rtmcg/PID-Temperature-Controller/README.md

# PHYS-339
Code and hardware schematics for the the new PID temperature controller lab in the Physics 339 laboratory course at McGill university.
