rtmcg/PID-Temperature-Controller/Images/GUI.PNG

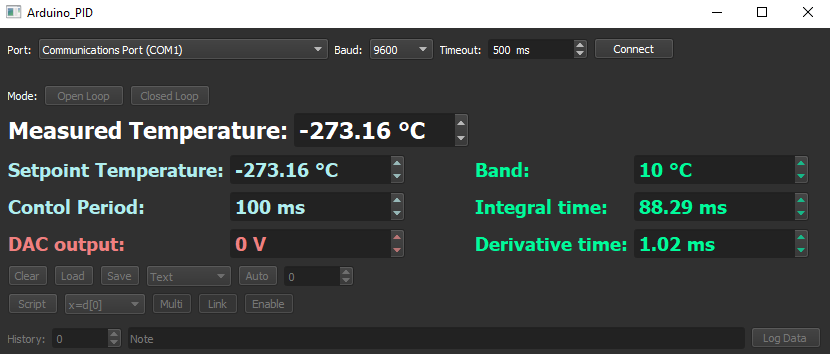
Images/GUI.PNG
