rtmcg/PID-Temperature-Controller/Images/GUI_plotting.PNG

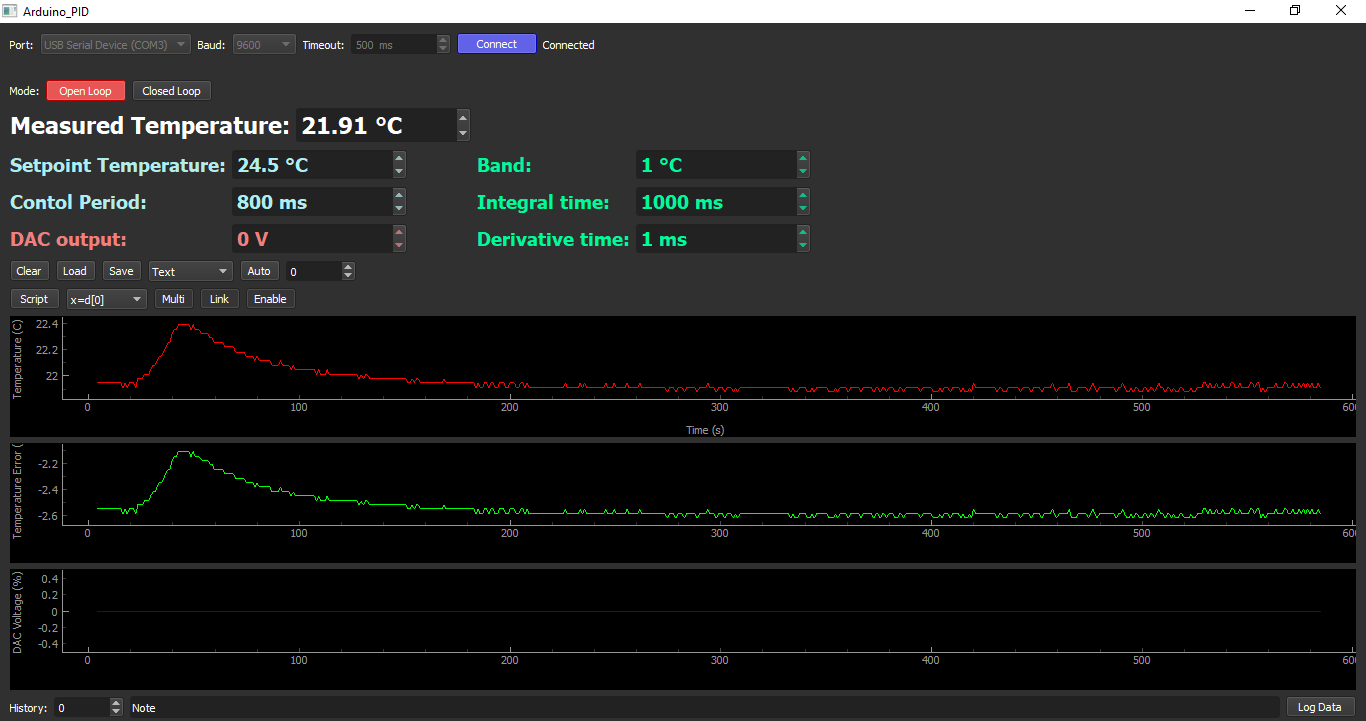
Images/GUI_plotting.PNG
