rtmcg/PID-Temperature-Controller/Electronics/PID_components_Digikey.xlsx

Index | Quantity | Part Number | Manufacturer Part Number | Description | Customer Reference | Available | Backorder | Unit Price | Extended Price USD
1 | 3 | 277-1580-ND | 1935190 | TERM BLK 5POS SIDE ENTRY 5MM PCB |  | 3 | 0 | 1.08 | 3.24
2 | 3 | 277-1578-ND | 1935174 | TERM BLK 3POS SIDE ENTRY 5MM PCB |  | 3 | 0 | 0.65 | 1.95
3 | 1 | PPC10.0KYCT-ND | SFR2500001002FR500 | RES 10K OHM 0.4W 1% AXIAL |  | 1 | 0 | 0.13 | 0.13
4 | 1 | 1109PHCT-ND | A104K15X7RF5TAA | CAP CER 0.1UF 50V X7R AXIAL |  | 1 | 0 | 0.26 | 0.26
5 | 1 | 1001PHCT-ND | A101J15C0GF5TAA | CAP CER 100PF 50V C0G/NP0 AXIAL |  | 1 | 0 | 0.29 | 0.29
6 | 1 | 2N7000BU-ND | 2N7000BU | MOSFET N-CH 60V 200MA TO92-3 |  | 1 | 0 | 0.42 | 0.42
7 | 1 | PPC20.0KYCT-ND | SFR2500002002FR500 | RES 20K OHM 0.4W 1% AXIAL |  | 1 | 0 | 0.13 | 0.13
8 | 1 | 470QBK-ND | CFR-25JB-52-470R | RES 470 OHM 5% 1/4W AXIAL |  | 1 | 0 | 0.1 | 0.10
9 | 1 | 296-7141-5-ND | LF412CP | IC OPAMP JFET 2 CIRCUIT 8DIP |  | 1 | 0 | 1.7 | 1.70
10 | 1 | 100KQBK-ND | CFR-25JB-52-100K | RES 100K OHM 5% 1/4W AXIAL |  | 1 | 0 | 0.1 | 0.10
