rtmcg/PID-Temperature-Controller/Electronics/Peltier Driver/PID_electronics.pdf

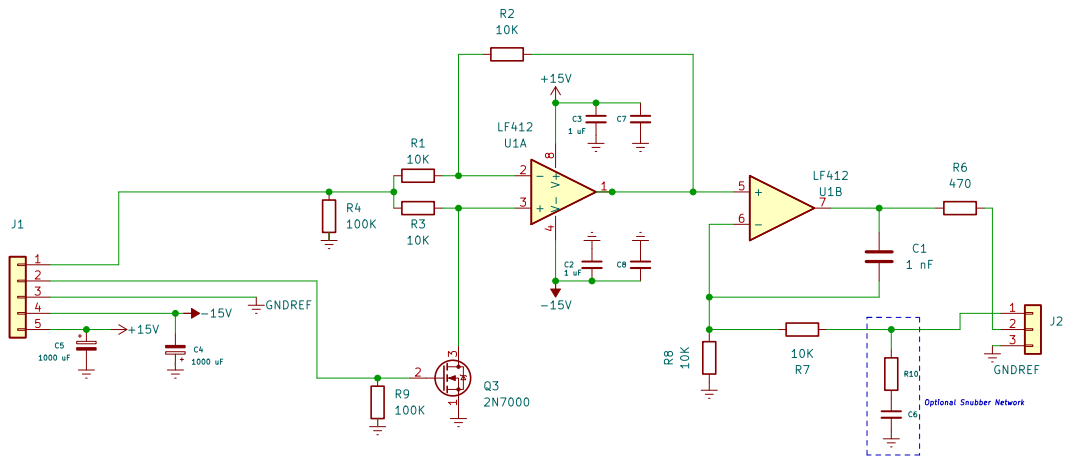
[picture p3: page 1]

File: PID_electronics.kicad_sch Sheet: / McGill University

Id: 1/1 Title: Peltier PID controller lab electronics
