rtmcg/PID-Temperature-Controller/Electronics/Peltier Driver/PID_electronics.kicad_pcb

## KiCad design Electronics/Peltier Driver/PID_electronics.kicad_pcb (2022-02-03)

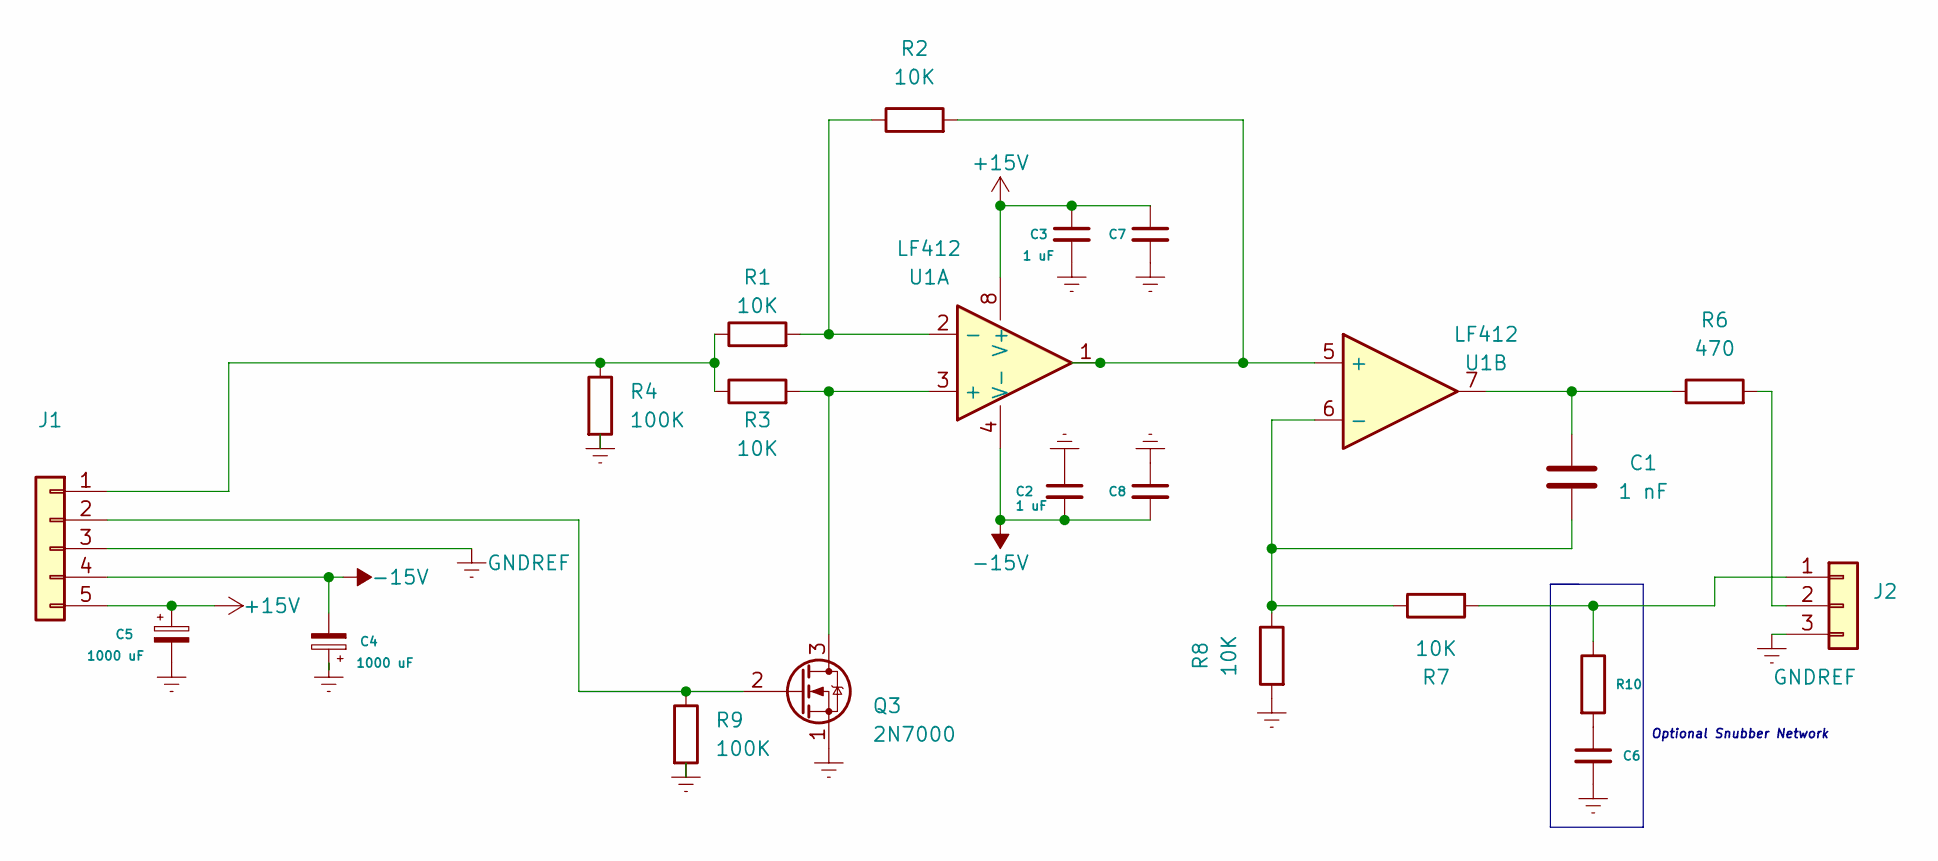
[picture p4: schematic PID_electronics.kicad_sch, Peltier PID controller lab electronics]

Parts:
C1: 1 nF; C_Axial_L3.8mm_D2.6mm_P7.50mm_Horizontal
C2, C3: 1 uF; C_Axial_L3.8mm_D2.6mm_P7.50mm_Horizontal
C4, C5: 1000 uF; CP_Radial_D10.0mm_P5.00mm
C6: C_Small; CP_Radial_D10.0mm_P5.00mm
C7, C8: C_Small; C_Axial_L3.8mm_D2.6mm_P7.50mm_Horizontal
J1: Conn_01x05; 1935190
J2: Conn_01x03; 1935174
Q3: 2N7000; TO-92_HandSolder
R1, R2, R3, R7, R8: 10K; R_Axial_DIN0207_L6.3mm_D2.5mm_P10.16mm_Horizontal
R4, R9: 100K; R_Axial_DIN0207_L6.3mm_D2.5mm_P10.16mm_Horizontal
R6: 470; R_Axial_DIN0207_L6.3mm_D2.5mm_P10.16mm_Horizontal
R10: R; R_Axial_DIN0207_L6.3mm_D2.5mm_P10.16mm_Horizontal
U1: LF412; DIP-8_W7.62mm_Socket_LongPads

Connections:
+15V: C3.1, C5.1, C7.1, J1.5, U1.8 (V+)
-15V: C2.2, C4.2, C8.2, J1.4, U1.4 (V-)
GNDREF: C2.1, C3.2, C4.1, C5.2, C6.2, C7.2, C8.1, J1.3, J2.3, Q3.1 (S), R4.2, R8.2, R9.2
unnamed: C1.1, R6.1, U1.7
unnamed: C1.2, R7.1, R8.1, U1.6 (-)
unnamed: J2.1, R7.2, R10.1
unnamed: J2.2, R6.2
unnamed: J1.2, Q3.2 (G), R9.1
unnamed: Q3.3 (D), R3.2, U1.3 (+)
unnamed: J1.1, R1.1, R3.1, R4.1
unnamed: R1.2, R2.1, U1.2 (-)
unnamed: R2.2, U1.1, U1.5 (+)
unnamed: C6.1, R10.2

Notes on the sheet:
Optional Snubber Network

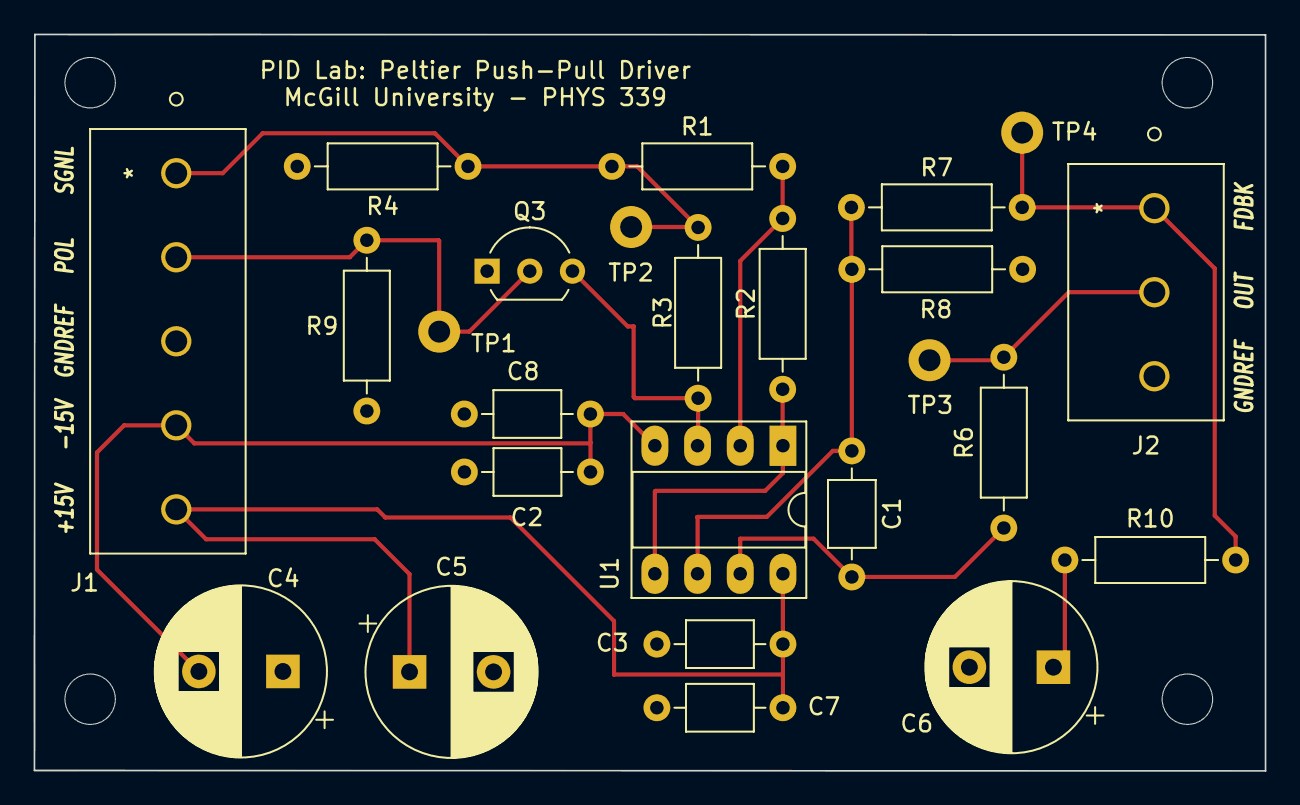
[picture p5: board PID_electronics.kicad_pcb from above]

Board: 2 copper layers, 73.2 x 43.8 mm, 21 parts (0 on the bottom side), 13 nets.
