rtmcg/PID-Temperature-Controller/(commit log)

2021-10-13 New implementation of arduino api and GUI based on mcphysics auber controller.
2021-10-13 Arduino Code begins
2021-10-14 Integrating arduino code and python api.
2021-10-18 Fixed simulation in the GUI
    [PID.ino]
2021-10-29 Api and arduino code fixes
    [PID.ino, get_and_set.ino]
2021-11-11 Major updates across the board
2021-11-18 Added functionality on both GUI and arduino side.
2021-11-19 breaking up arduino.py
2021-11-19 Broke up arduino.py into api and gui scripts.
2021-11-29 Added RTD temperature measurement (MAX31865 ic)
2021-12-03 Added functionality for changing control period from gui and a single function to get all parameters from arduino to the api (get_all_variables) to simplify querying of the arduino.
2021-12-07 Removed the GUI window population code from init to clean up the code, added provision from automatically finding arduino serial port.
2022-01-11 CAD files for supporting electronics
    [PID_electronics-B_Cu.gbr, PID_electronics-B_Mask.gbr, PID_electronics-B_Paste.gbr, PID_electronics-B_Silkscreen.gbr, PID_electronics-Edge_Cuts.gbr, PID_electronics-F_Cu.gbr, PID_electronics-F_Mask.gbr, PID_electronics-F_Paste.gbr]
2022-01-12 Test Arduino shield for RTD breakout board
    [RTD_shield.kicad_pcb, RTD_shield.kicad_sch]
2022-01-12 Terminal block footprints
2022-01-12 File reorganization
    [PID_electronics-B_Cu.gbr, PID_electronics-B_Mask.gbr, PID_electronics-B_Paste.gbr, PID_electronics-B_Silkscreen.gbr, PID_electronics-Edge_Cuts.gbr, PID_electronics-F_Cu.gbr, PID_electronics-F_Mask.gbr, PID_electronics-F_Paste.gbr]
2022-01-12 File reorg
    [PID_electronics.kicad_pcb, PID_electronics.kicad_sch, RTD_shield.kicad_pcb, RTD_shield.kicad_sch]
2022-01-13 Combined schematic of 3 electronics blocks
2022-01-13 Combined schematic of 3 electronics blocks (minor change)
2022-01-14 updated silkscreen
    [PID_electronics.kicad_pcb, PID_electronics.kicad_sch, RTD_shield.kicad_pcb, RTD_shield.kicad_sch]
2022-01-14 Components for PCB construction
    [PID_components_Digikey.xlsx]
2022-01-14 schematic image added
2022-01-14 Gerber files for PCB production
    [PID_electronics-B_Cu.gbr, PID_electronics-B_Mask.gbr, PID_electronics-B_Paste.gbr, PID_electronics-B_Silkscreen.gbr, PID_electronics-Edge_Cuts.gbr, PID_electronics-F_Cu.gbr, PID_electronics-F_Mask.gbr, PID_electronics-F_Paste.gbr]
2022-01-14 minor changes
    [RTD_shield.kicad_pcb, RTD_shield.kicad_sch]
2022-01-21 Added mounting holes
    [PID_electronics.kicad_pcb]
2022-01-21 mounting hole footprint
2022-01-24 Board revision
    [PID_electronics.kicad_pcb]
2022-01-31 Added Bulk decoupling capacitors and optional snubber network
    [PID_electronics-B_Cu.gbr, PID_electronics-B_Mask.gbr, PID_electronics-B_Paste.gbr, PID_electronics-B_Silkscreen.gbr, PID_electronics-Edge_Cuts.gbr, PID_electronics-F_Cu.gbr, PID_electronics-F_Mask.gbr, PID_electronics-F_Paste.gbr]
2022-02-01 Added additional optional bypass capacitors
    [PID_electronics-B_Cu.gbr, PID_electronics-B_Mask.gbr, PID_electronics-B_Paste.gbr, PID_electronics-B_Silkscreen.gbr, PID_electronics-Edge_Cuts.gbr, PID_electronics-F_Cu.gbr, PID_electronics-F_Mask.gbr, PID_electronics-F_Paste.gbr]
2022-02-01 Replaced Opamp footprint with socket footprint
    [PID_electronics.kicad_pcb, PID_electronics.kicad_sch]
2022-02-02 Added test points, changed 2n7000 T0-92 footprint
    [PID_electronics.kicad_pcb, PID_electronics.kicad_sch, RTD_shield.kicad_pcb, RTD_shield.kicad_sch]
2022-02-03 Layout optimization, mounting hole addition
    [PID_electronics-B_Cu.gbr, PID_electronics-B_Mask.gbr, PID_electronics-B_Paste.gbr, PID_electronics-B_Silkscreen.gbr, PID_electronics-Edge_Cuts.gbr, PID_electronics-F_Cu.gbr, PID_electronics-F_Mask.gbr, PID_electronics-F_Paste.gbr]
2022-02-03 2N7000 footprint change, gerbers generated
    [PID_electronics-B_Cu.gbr, PID_electronics-B_Mask.gbr, PID_electronics-B_Paste.gbr, PID_electronics-B_Silkscreen.gbr, PID_electronics-Edge_Cuts.gbr, PID_electronics-F_Cu.gbr, PID_electronics-F_Mask.gbr, PID_electronics-F_Paste.gbr]
2022-02-03 minor layout change
    [PID_electronics-B_Cu.gbr, PID_electronics-B_Mask.gbr, PID_electronics-B_Paste.gbr, PID_electronics-B_Silkscreen.gbr, PID_electronics-Edge_Cuts.gbr, PID_electronics-F_Cu.gbr, PID_electronics-F_Mask.gbr, PID_electronics-F_Paste.gbr]
2022-02-15 Schematic PDF
2022-03-11 Changed Polarity and RTD module pin assignments foruse in 339 labs
